RTGS-Lab/li710-external-12v-battery/README.md

# li710-external-12v-battery
The Li710 ET Sensor requires an external 12V battery to operate, its design can be found here
