RTGS-Lab/li710-external-12v-battery/KestrelPathDiagram.png

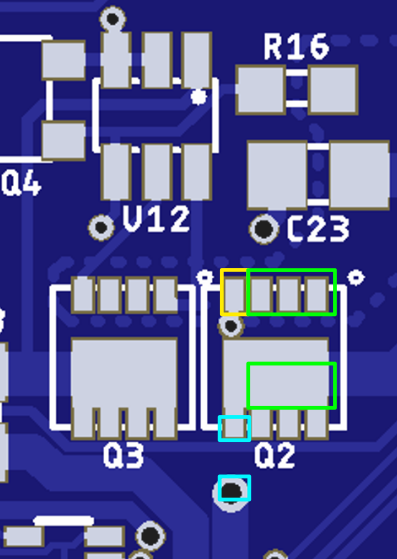
KestrelPathDiagram.png
