RTGS-Lab/li710-external-12v-battery/BoM.xlsx

Item | Vendor | Part Number | Qty | Link
Battery Box | McMaster | 69995K81 | 1 | https://www.mcmaster.com/69995K81/
Washer, Stainless, 1/4" | McMaster | 92141A029 | 4 | https://www.mcmaster.com/92141A029/
Screw, Stainless, 1/4"-20, 1/2" | McMaster | 91772A537 | 2 | https://www.mcmaster.com/91772A537/
Washer, Stainless, Lock | McMaster | 95584A207 | 2 | https://www.mcmaster.com/catalog/95584A207
Nut, Stainless, Hex, 1/4"-20 | McMaster | 91845A029 | 2 | https://www.mcmaster.com/catalog/91845A029
Ring terminal, 1/4" | McMaster | 7113K13 | 2 | https://www.mcmaster.com/catalog/7113K13
Spade terminal, #10, 16-14 AWG | McMaster | 69145K61 |  | https://www.mcmaster.com/catalog/69145K61
Spade terminal, #10, 22-18 AWG | McMaster | 69145K433 |  | https://www.mcmaster.com/catalog/69145K433
Wire, stranded, yellow | McMaster | 8054T16 |  | https://www.mcmaster.com/catalog/8054T16
Wire, stranded, black | McMaster | 8054T16 |  | https://www.mcmaster.com/catalog/8054T16
Heat shrink tubing, red | McMaster | 7496K42 |  | https://www.mcmaster.com/catalog/7496K42
Heat shrink tubing, black | McMaster | 7496K42 |  | https://www.mcmaster.com/catalog/7496K42
Terminal Block | McMaster | 7527K44 | 1 | https://www.mcmaster.com/7527K44/
Jumper | McMaster | 7527K59 | 2 | https://www.mcmaster.com/catalog/7527K59
Screw, Stainless, #4 Thread Forming | McMaster | 97349A100 | 4 | https://www.mcmaster.com/97349A100/
Washer, Nylon, #4 | McMaster | 90295A345 | 4 | https://www.mcmaster.com/90295A345-90295A045/
Washer, Stainless, #4 | McMaster | 92141A005 | 4 | https://www.mcmaster.com/92141A005/
Washer, Stainless, #6 | McMaster | 92141A008 | 8 | https://www.mcmaster.com/92141A008/
Screw, Stainless, #6 Thread Forming | McMaster | 96001A260 | 4 | https://www.mcmaster.com/96001A260/
Screw, Stainless, #6, Torx, Thread Forming | McMaster | 96001A260 | 4 | https://www.mcmaster.com/96001A260/
Wire Nut | McMaster | 7108K51 | 1 | https://www.mcmaster.com/7108K51/
Battery | Amazon | ML35-12-12 V | 1 | https://www.amazon.com/ML35-12-Battery-Mighty-Brand-Product/dp/B00K8V2VD0
Extension cable, 10' | Voltaic Systems | W031 | 1 | https://voltaicsystems.com/W031/
Extension cable, 4' | Voltaic Systems | W036 | 1 | https://voltaicsystems.com/W036/
Solar panel | Voltaic Systems | P107C | 1 | https://voltaicsystems.com/9-watt-18v-panel/
Bracket | Voltaic Systems | BK103 | 1 | https://voltaicsystems.com/BK103
SunSaver | Amazon | PWM 6A 12V - LVD | 1 | https://www.amazon.com/dp/B002MQOXVC?s=industrial&sp_csd=d2lkZ2V0TmFtZT1zcF9kZXRhaWw
VHB Tape | Amazon
Mounting Plate | Custom |  | 1
Mounting Tabs | Custom |  | 2
