RTGS-Lab/li710-external-12v-battery/KestrelPathDiagram_Components.png

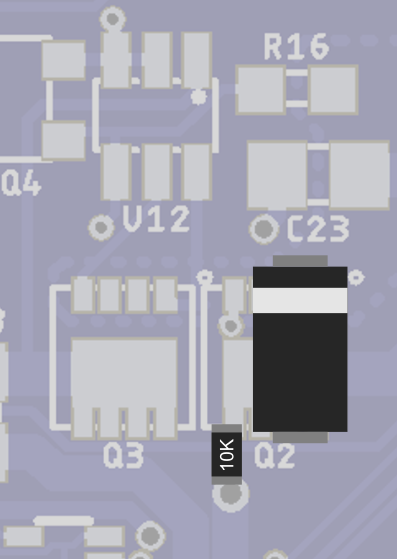
KestrelPathDiagram_Components.png
