RTGS-Lab/li710-external-12v-battery/BatteryPlate_v1.DXF

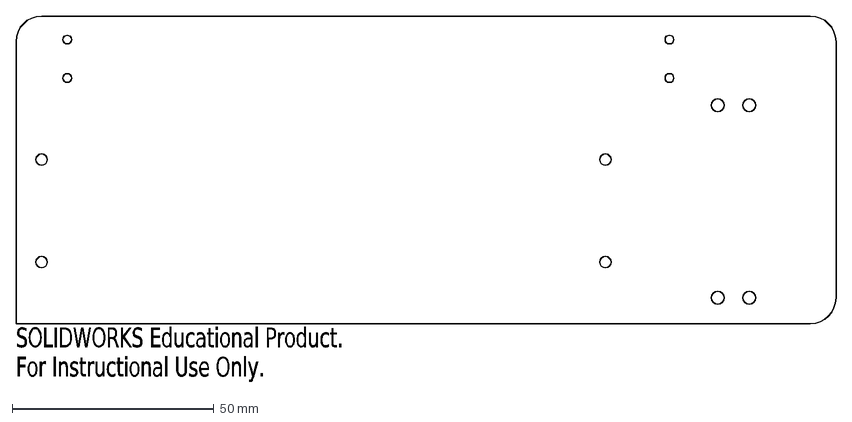
[picture p3: CAD file, 2025-04-14]
BatteryPlate_v1.DXF
SOLIDWORKS Educational Product.
For Instructional Use Only.
