RTGS-Lab/li710-external-12v-battery/BatteryTabs.DXF

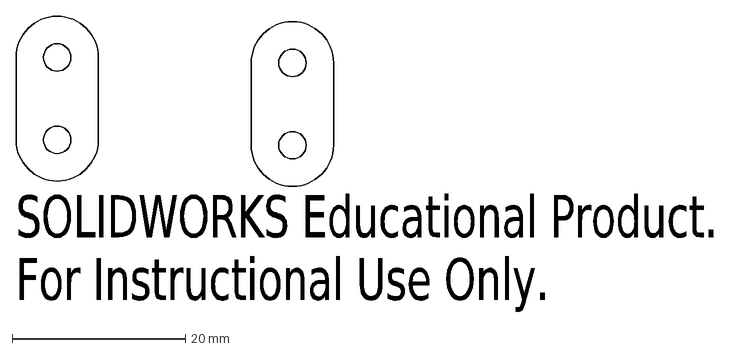
[picture p4: CAD file, 2025-04-14]
BatteryTabs.DXF
SOLIDWORKS Educational Product.
For Instructional Use Only.
