RTGS-Lab/li710-external-12v-battery/BoxDiagram.pdf

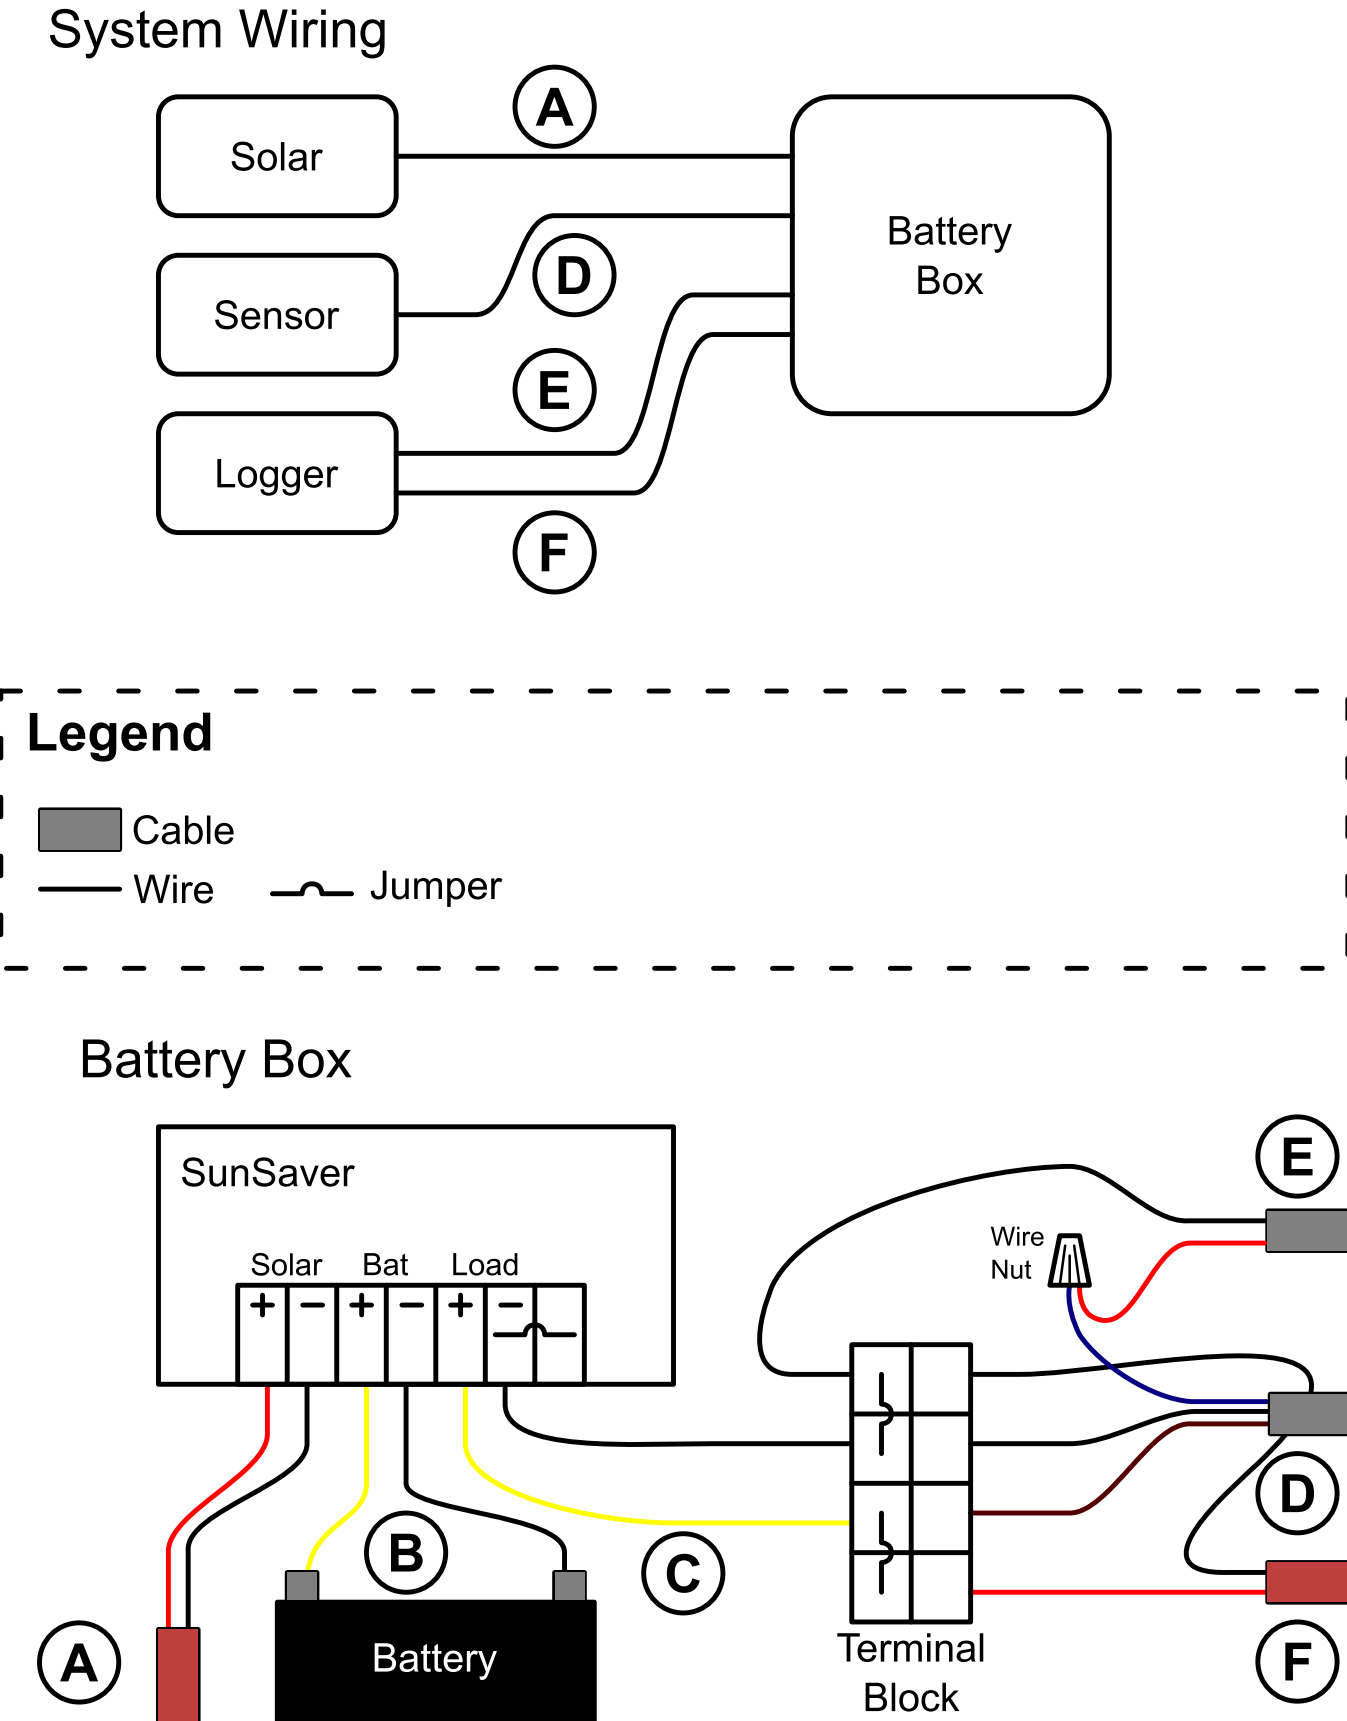
[picture p5: page 1]
