RTGS-Lab/li710-external-12v-battery/BoxDiagram_wImages.pdf

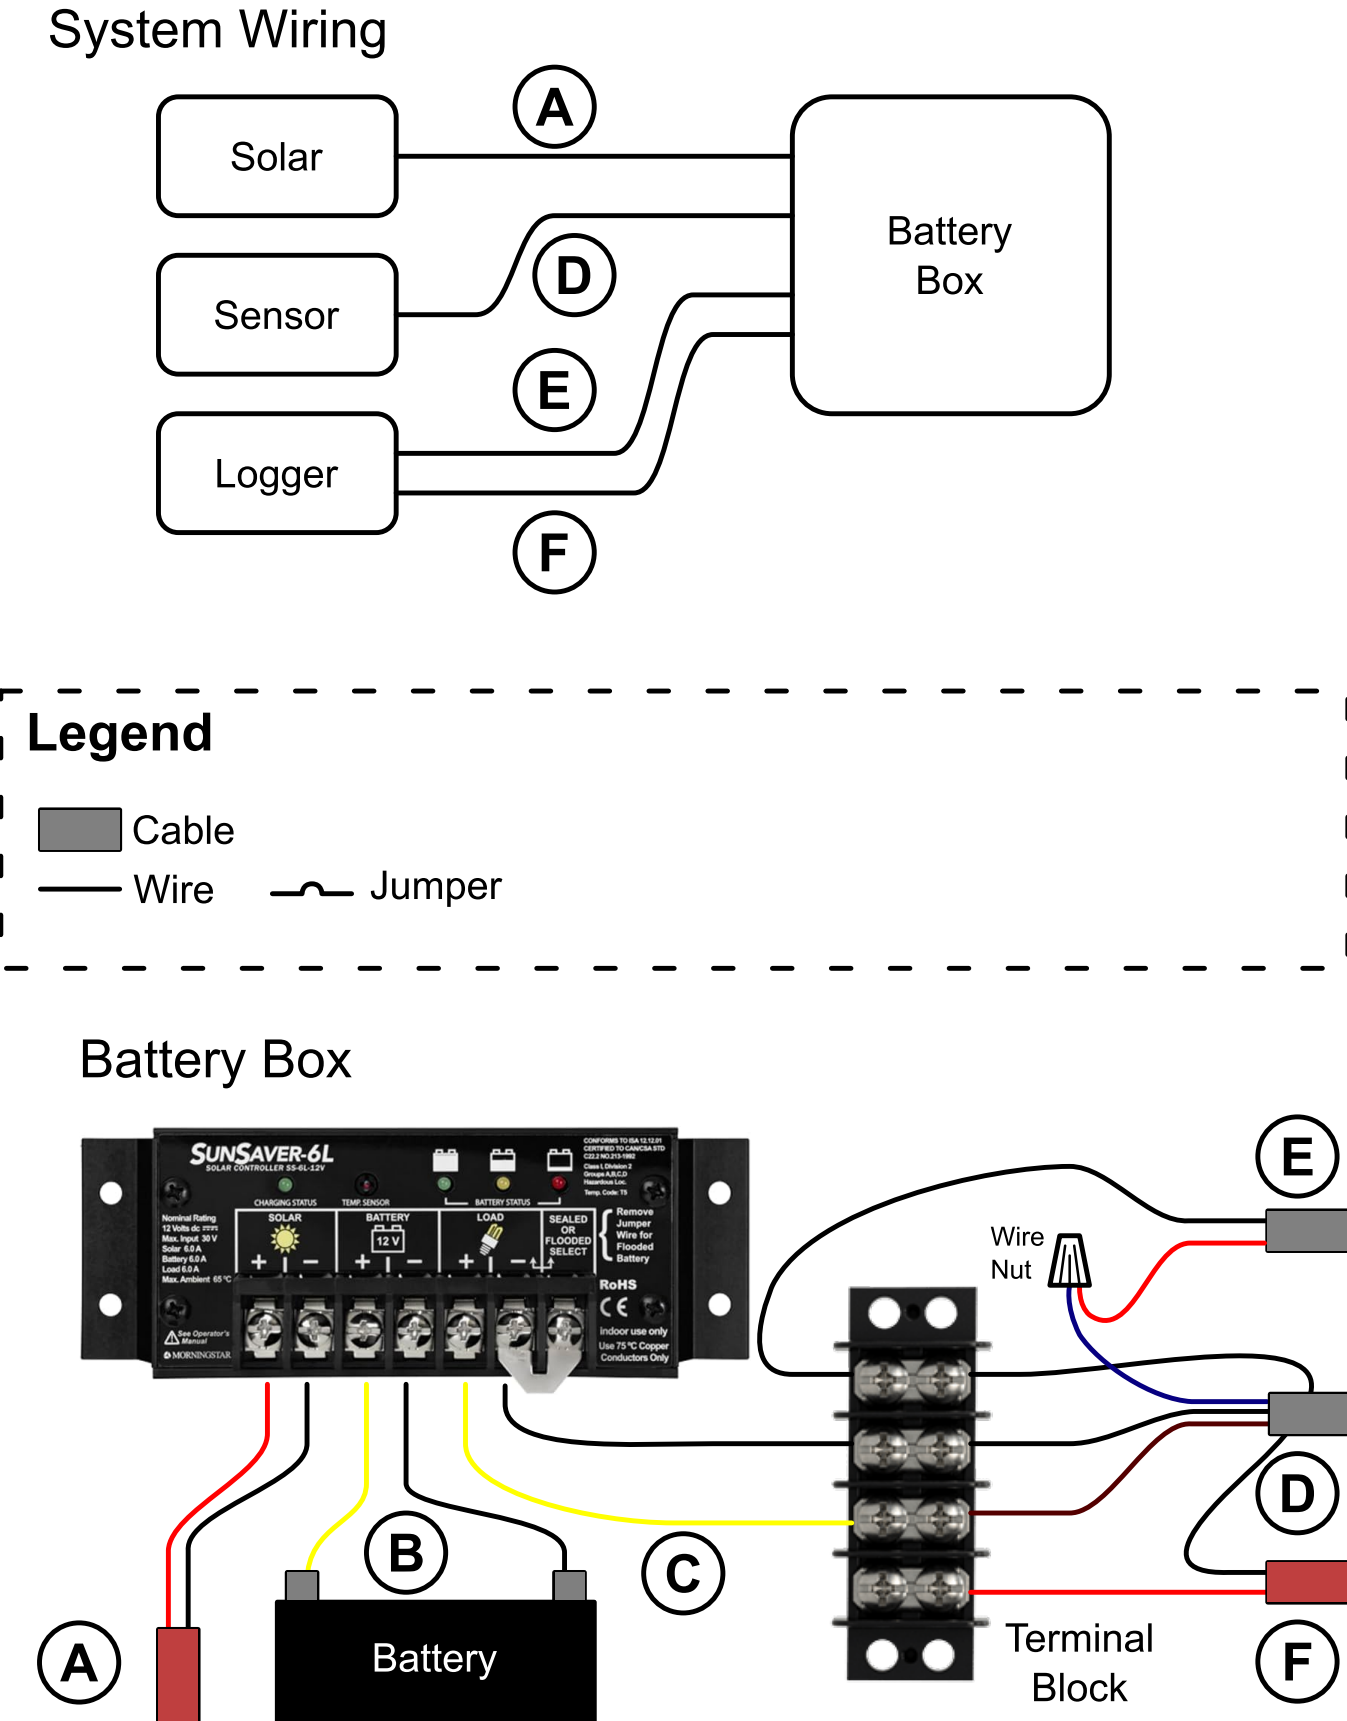
[picture p6: page 1]
