RTGS-Lab/li710-external-12v-battery/CablePrepDiagram.pdf

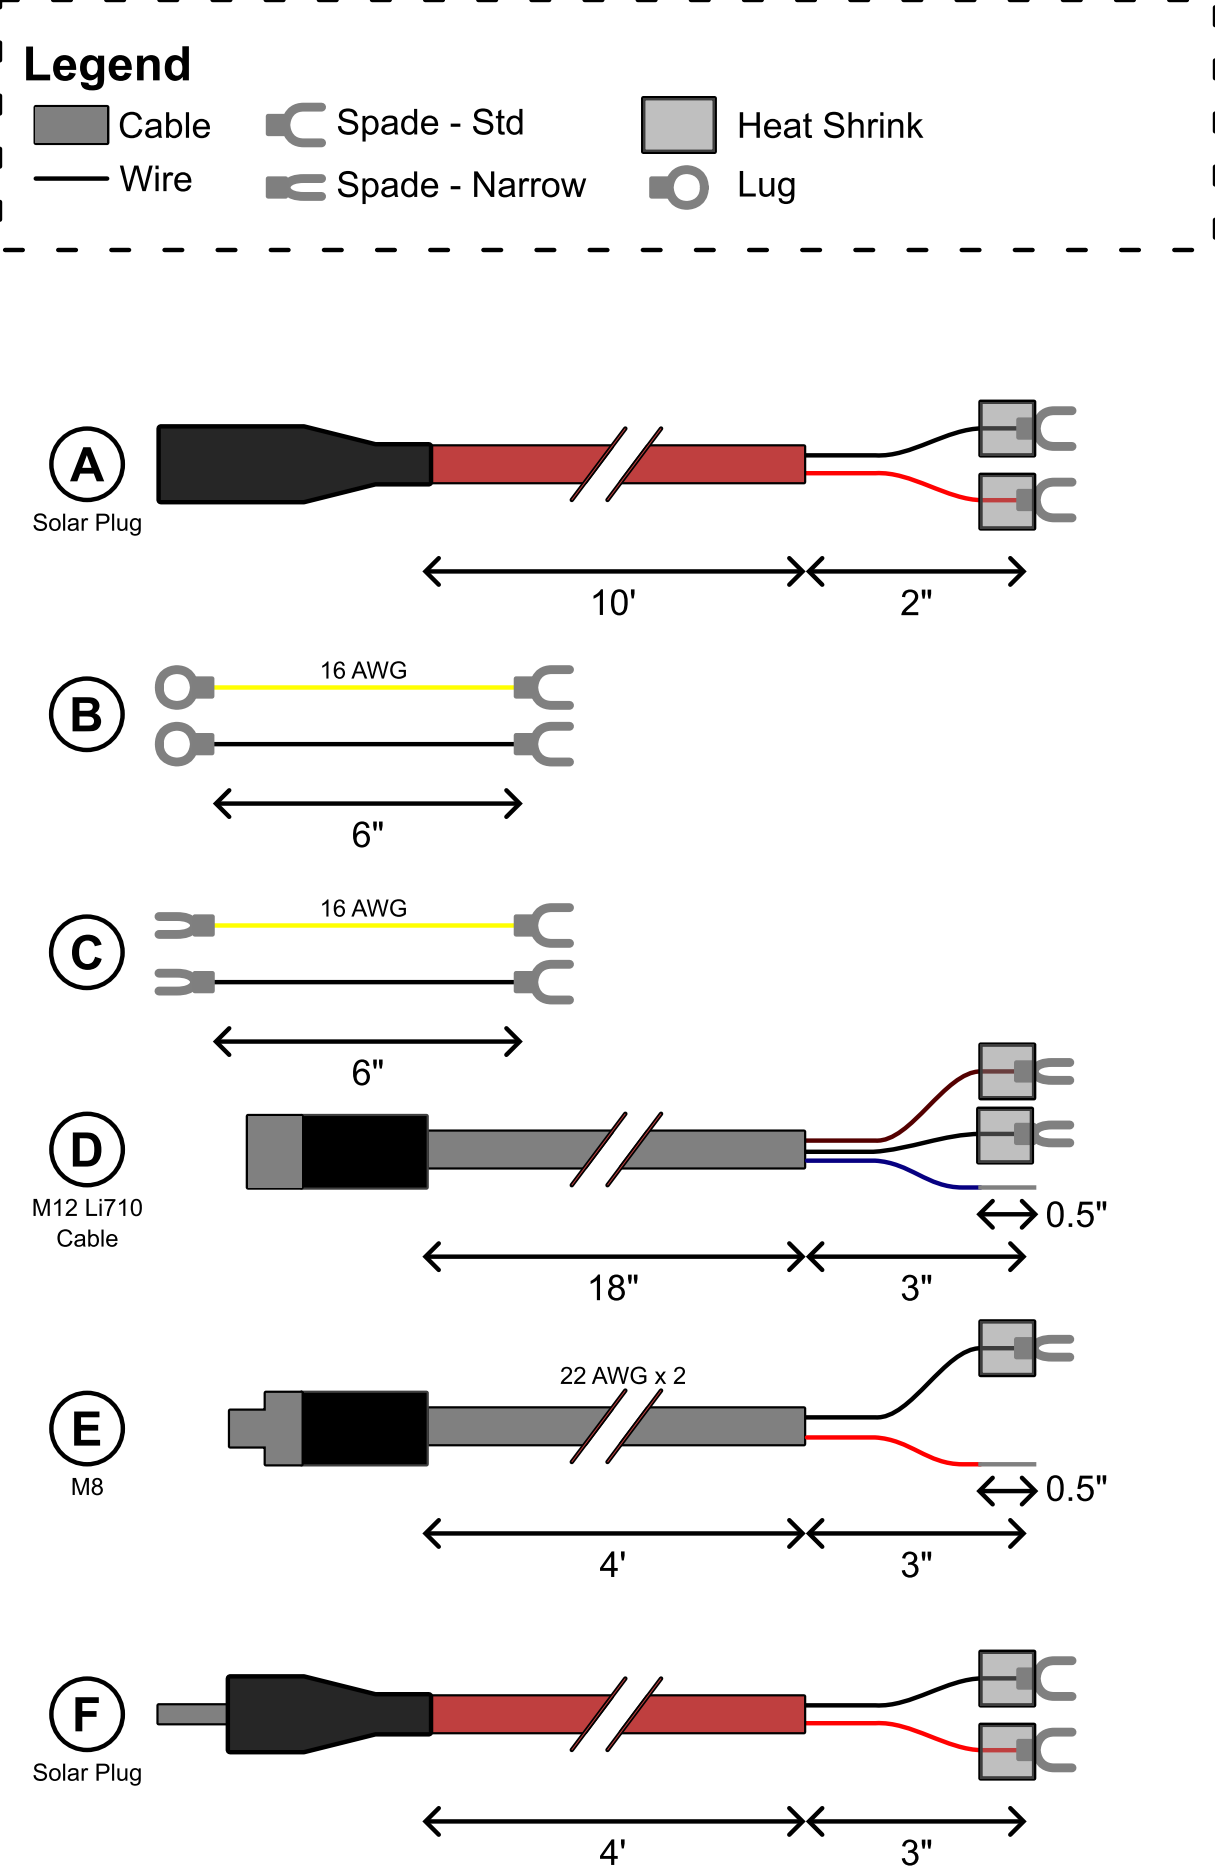
[picture p7: page 1]
