RTGS-Lab/li710-external-12v-battery/Assembly.docx

Tools Required:

- #1 phillips screwdriver
- #2 phillips screwdriver
- T15 Torx screwdriver
- 7/16” wrench
- Wire strippers
- Heat gun
- Crimping tool (e.g. Klein 3005CR (https://www.amazon.com/Klein-Tools-Ratcheting-Crimper-10-22/dp/B07WMB61J5?c=ts&s=power-hand-tools&ts_id=553392))
1. Construct all cables as detailed in the cable construction guide (https://drive.google.com/file/d/1-eTe70jzcJaVhNm0RobxFWu4NYZjLVdb/view?usp=drive_link)
2. Construct mounting plates (https://drive.google.com/file/d/1Hw5JMth8mXJvGxWWAxy1C_2KoKJoarS8/view?usp=drive_link) and tabs (https://drive.google.com/file/d/1YQl14s3h36hncwXrZbpH8KBMy8t9KzEA/view?usp=drive_link)
  a. Laser cut from ⅛” (3mm) acrylic (example (https://www.mcmaster.com/8589K41/)) - can be done in-house or ordered from a manufacturer such as Ponoko (Clear Acrylic, 3mm)
3. Assemble battery board
  a. Connect cable tabs to the mounting plate using #4 thread cutting screw, #4 nylon washer (between mounting plate and cable tab) and #4 stainless washer (between screw head and cable tab). Do not over tighten screws, these are easy to strip.
  b. Connect SunSaver charge controller to mounting plate using ¼” long #6 thread cutting screws and #6 stainless washers. Do not over tighten screws, these are easy to strip.
  c. Connect terminal block to mounting plate using ⅜” long #6 Torx thread cutting screws and #6 stainless washers. Do not over tighten screws, these are easy to strip.
4. Attach mounting plate to top of battery using VHB tape
5. Connect cables as described in the box wiring diagram (https://drive.google.com/file/d/1-Pikz5b8dTmTV2ZjM8E4xKqy3X7s7Jmq/view?usp=drive_link)
  a. Charge battery using wall car battery charger
  b. Connect solar cable (A) to SunSaver
  c. Connect SunSaver to terminal block (C)
  d. Connect logger power to terminal block (F)
  e. Connect logger data to terminal block (E)
  f. Connect sensor cable to terminal block (D)
  g. Connect logger data and sensor data together - wire nut
  h. Connect battery to SunSaver (B) - Negative first
    - Connect spades to battery posts using ¼”-20 screw and nut with stainless washers on both sides along with lock washer on the nut side - tighten firmly
6. Place battery assembly inside of battery box
7. Secure cable to tabs using zip ties
