RTGS-Lab/li710-external-12v-battery/KestrelPathDiagram_TestPoints.png

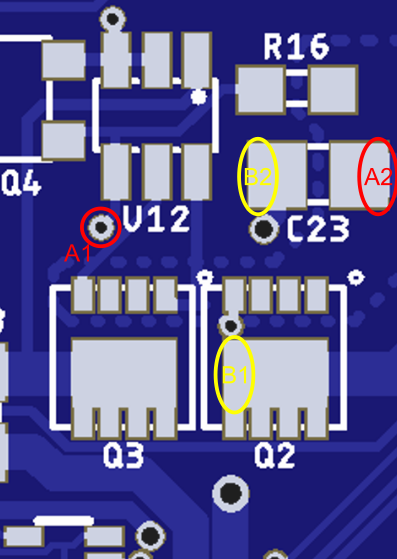
KestrelPathDiagram_TestPoints.png
